Rapidonot/wafer-fpga-accelerator/(commit log)

2026-10-31 Add Tang Nano 9K pin constraints
2026-10-31 Add host script to send wafers to the board and read results
2026-10-31 Add live demo window for filming the board
2026-10-31 Add demo GIF of the board classifying test wafers
2026-10-31 Add full demo video of the board classifying test wafers
